Lightwell-bg/LWClock/images/LWCKIT2-06.png

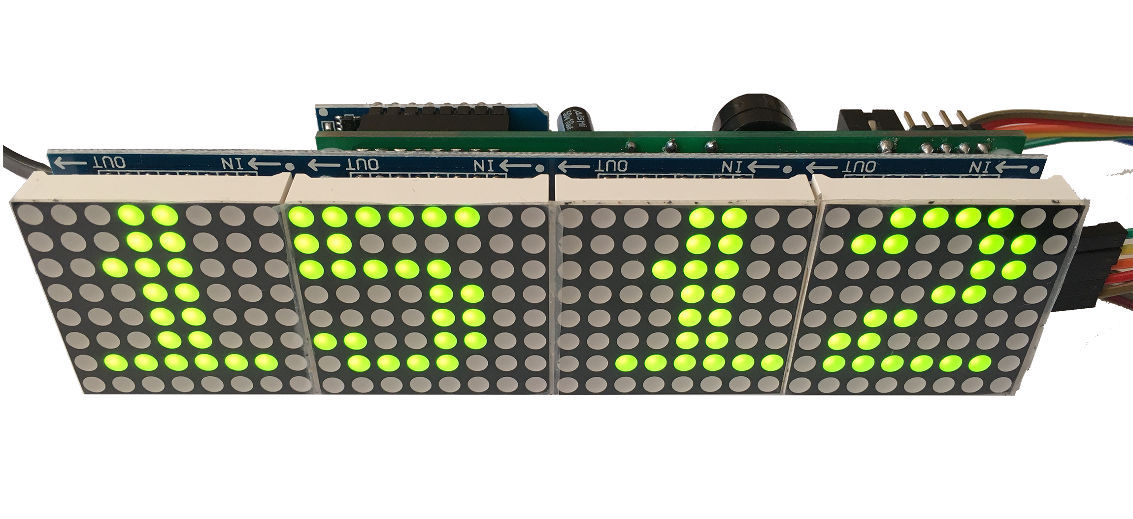
images/LWCKIT2-06.png
