Lightwell-bg/LWClock/images/LWCKIT2-07.png

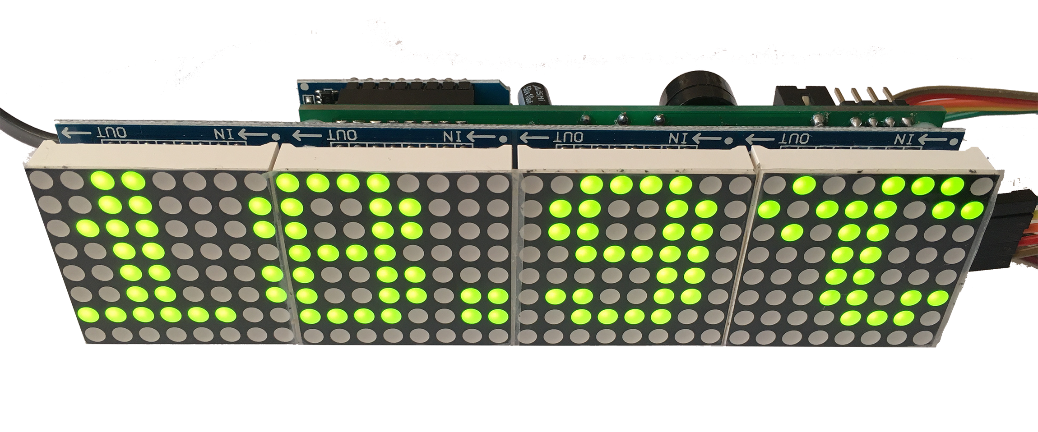
images/LWCKIT2-07.png
