Lightwell-bg/LWClock/images/lwclock-01.png

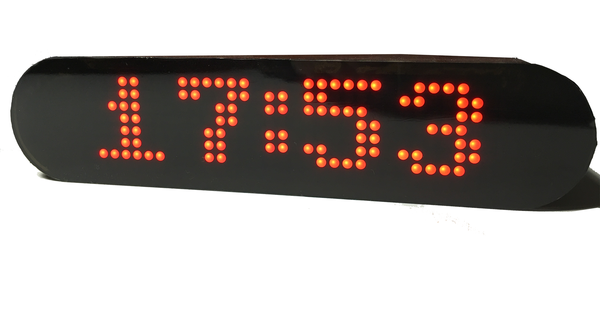
images/lwclock-01.png
