Lightwell-bg/LWClock/images/lwclock-02.png

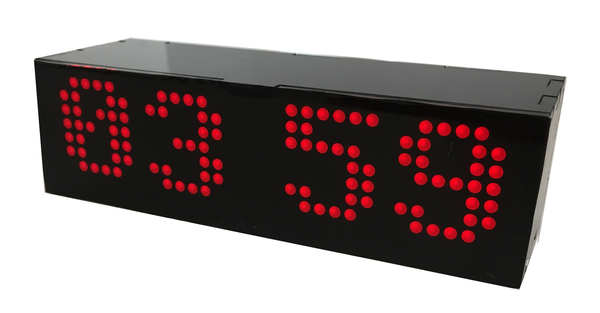
images/lwclock-02.png
