Lightwell-bg/LWClock/images/tspeak-01.png

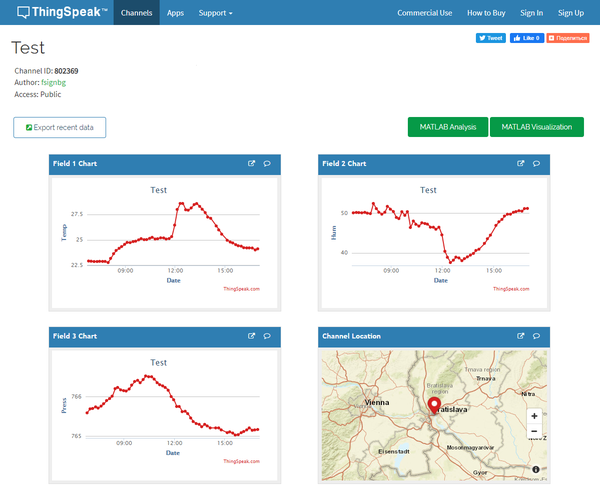
images/tspeak-01.png
