Lightwell-bg/LWClock/images/tspeak-02.PNG

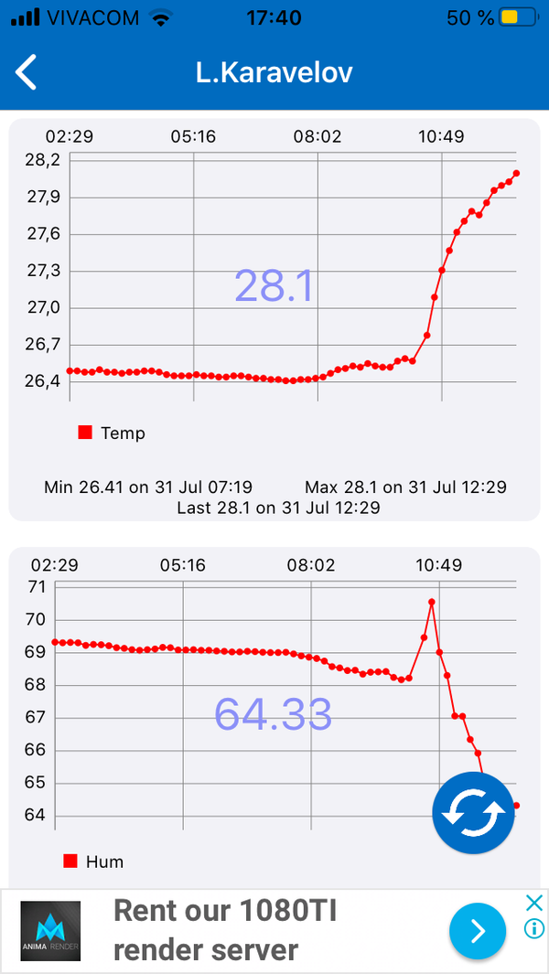
images/tspeak-02.PNG
