Lightwell-bg/LWClock/(threads)

Thread 1 (2020-02-12):

MQTT

jsponz, 2020-02-12:
Thanks for your nice project. I really like it.

My only question is about MQTT. I have made the configuration for the connection to my broker and I receive different values as the ones shown on the admin panel.

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

Any help?

Thanks in advance.

P.S: I am using your default compilation v2.0

Lightwell-bg, 2020-02-12:
You need to configure the settings for MQTT on page
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
You can find this page in menu when you are on "Setup".

jsponz, 2020-02-12:
It is already configured. I receive date in the MQTT broker, but the values
are different. Check the screens.

Thanks!

El mié., 12 feb. 2020 a las 17:52, Lightwell (<notifications@github.com>)
escribió:

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

--
Jorge-Luis Sánchez-Ponz
e. j.s.ponz@ieee.org

Lightwell-bg, 2020-02-12:
I understood. In scetch is correction for temp and hum depending on the brightness of the indicator. But no correction for sending to MQTT and thingspeak.com.  This was done when the sensor was inside the case.
switch (brightnow) {
    case 0:
      tempBME = tempBME - 0.09;
    break;
    case 1:
      tempBME = tempBME - 0.57;
    break;
    case 2:
      tempBME = tempBME - 1.04;
    break;
    case 3:
      tempBME = tempBME - 1.66;
.....................
I may remote correction or enable/disable it in the web interface

jsponz, 2020-02-12:
Ok. I guess that explains also the difference for the other values.

Maybe a good idea is to have the change to make the corrections from the
admin panel. For example for the temperature from -5 to +5 and the user
based on the case decides to make the correction.

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
--
Jorge-Luis Sánchez-Ponz
e. j.s.ponz@ieee.org

Lightwell-bg, 2020-02-12:
I'll make on/off correction and choice of "mm" or hPa (for pressure) with admin panel

jsponz, 2020-02-13:
Ok. Thanks!

Looking forward to it!

Lightwell-bg, 2020-02-13:
I've added a selection of disabling adjustments for temp&hum and select unit for pressure (only for send to MQTT). Please update FS and scetch.

jsponz, 2020-02-13:
Thanks! I will check it!

jsponz, 2020-02-18:
Just to confirm it works! Thanks!

Closed 2020-02-14.

Thread 2 (2020-02-18):

Wrong version information on the compiled version

jsponz, 2020-02-18:
I have just used the version "LWClockV2.0-noRTC.bin", but the version information is wrong. Check attached image.

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

Lightwell-bg, 2020-02-18:
Please update firmware with new BIN file

Closed 2020-02-21.

Thread 3 (2020-02-23):

FileNotFound

AlexKholodkov, 2020-02-23:
Hi, thanks for your wonderful project!
But at the first start, I can’t see the web interface, in the browser I see only FileNoteFound  ( successfully connected to AP 192.168.4.1)

>
11:20:57.137 -> Failed to open config file
11:20:57.270 -> FileConfig
11:20:57.270 -> Start screen
11:20:57.270 -> Loading config EEPROM
11:20:57.469 -> ........Start WIFI

Lightwell-bg, 2020-02-23:
You must upload SPIFFS. File spiffs.bin
14. Upload the sketch data files (the data directory in the sketch folder) using Tools > ESP8266 Sketch Data Upload.

AlexKholodkov, 2020-02-23:
Ok, thanks a lot!
(https://github.com/esp8266/arduino-esp8266fs-plugin)

Closed 2020-02-23.

Thread 5 (2020-10-03):

No file found at webpage 192.168.4.1

ChrLHL, 2020-10-03:
Hi Lightwell,

I just assembelt your clock. The electric works so far, but i cant reach the webpage to configurate the clock.

The only output I get is FileNotFound .

Could you have  a look on it?

Thak you very much.
Best regards
Christian

Mohin2005, 2020-10-06:
Hey @ChrLHL , I am interested in your project, could your please share your project to me? So that I can try to help you out of this

ChrLHL, 2020-10-06:
Hi Mohin2005,

thanks that would be great.
So first of all, i used the 3D prnted case, i will cut out the plexiglas soon.
I dind't used the pcb, instead i printed a holder for all of the single components an wired them.

So the wireing is correcht an the clock shows date time and after a while the data from the BMP. The BMP reads heat emmisions from the other components, here also be said, thats the first "prototype" oft the wired solution.

When i start the LW clock everything is working.
Then id like to configurate the time, date and so on over the web interface. As in the instruction I connect my phone to the wifi of the esp and browse to 192.168.4.1.

Now the problem is that i reach the webpage but there is no content on it.
i see that:

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

So thats all.Oh thats not all, sorry.
As i programmed the esp there is to mention that i am not sure about the step 8. "In Tools > Flash Size: select 4M (1M SPIFFS) -- this project requires SPIFFS for saving and reading configuration settings."
Well i Choose those Settings:

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

Sould there be the option SPIFFS instead of OTA?
The flash sizes are correct, ist just a screenshot from the menu.

Now thats all.

Thank you very much so far.
Best regards
Christian

Lightwell-bg, 2020-10-06:
....
14. Upload the sketch data files (the data directory in the sketch folder) using Tools > ESP8266 Sketch Data Upload.

ChrLHL, 2020-10-29:
Hi,

thanks for the help. Of course the error was sitting in front of the screen ;-).

But i've got another, possible not so dump, question.  I'd like to tun of the diagonal fading of the time and just want, that the screen clears itself witout any effect. So if just time is displayed it looks more or less static.

Thanks a lot
Christian

Freeejack, 2020-12-16:
Hi,

I have the same issue like above. FileNotFound. Checked many times every library and uploaded the sketch (lwclockv22.ino) and data, but no success.

What can cause this?

It works like all the leds are on, but nothing more. Can you please help me with this?

Lightwell-bg, 2020-12-16:
Hi,
Do you use version with SPIFFS or LITTLFFS?
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

Freeejack, 2020-12-16:
Hi,
Thank you for the fast answer. In have only the Sketch Data Upload menu item. The littleFS no, so this is the source of the error?

Lightwell-bg, 2020-12-16:
Arduino ESP8266 LittleFS Filesystem Uploader
https://github.com/earlephilhower/arduino-esp8266littlefs-plugin

Closed 2021-01-17.

Thread 6 (2021-01-15):

wont connect to wifi

victor7376, 2021-01-15:
I've followed all guide and then put in my wifi details but nothing happens it just refuses to connect and keeps in AP mode.

I've tried resetting to factory defaults but it still has the wifi details within the page that should of been reset.

Any help would be grateful.

Freeejack, 2021-09-28:
I have this problem too. I changed my wifi router to a newer model, and after that it wont connect to wifi. The weather is not displayed. The system remains in AP mode, i can connect to the clock with the 192.168.4.1 IP address.
If i switch off the new router and connect back the old one, it works like a charm. What can cause this problem? SSID and pass not changed.

Lightwell-bg, 2021-09-29:
I think you have problem with router or ESP board (unfortunately on the market there are a lot of low-quality ESP8266). Try to change ESP board.

Freeejack, 2021-10-01:
Thanks for the answer. Because with my old router it works as expected i don't think that the board are the source of this error. But everything in my house (20+ wifi devices) works without any error with the new router.
Thanks in advance, i try another code and it turns out what's wrong.

Closed 2021-10-05.
