Lightwell-bg/LWClock/(commit log)

2019-11-30 add Sea temperature modified: BIN/LWClockV1.0.bin modified: BIN/spiffs.bin modified: lw-clock/FileConfig.ino modified: lw-clock/SrvHTTP.ino modified: lw-clock/Weather.ino modified: lw-clock/config.h 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
2020-02-11 Add library NetCrtESP. ESP8266 and ESP32 WiFi Connection manager with with storage of settings in EEPROM modified: README.md modified: lw-clock/FileConfig.ino modified: lw-clock/SrvHTTP.ino modified: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
2020-02-13 Add on/off correction temp&hum and selection unit (mm, hPa) for pressition new file: BIN/LWClockV2.0-RTC.bin modified: BIN/spiffs.bin modified: lw-clock/FileConfig.ino modified: lw-clock/LWClockV2.0.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
    [FileConfig.ino, LWClockV2.0.ino, SrvHTTP.ino, config.h, mqtt.ino]
2020-12-03 Change SPIFFS -> LITTLEFS Fix errors new file: BIN/LWClockV2.2..d1_miniDHT22.bin new file: BIN/LWClockV2.2.d1_miniRTC.bin new file: BIN/LWClockV2.2.d1_mini_noRTC.bin new file: BIN/LWClockV2.2.mklittl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
    [Display.ino, FileConfig.ino, FileSystem.ino, LWClockV2.1.ino, LWClockV2.2.ino, SrvHTTP.ino, Time.ino, TimeGetGlobal.ino]
